DavidGilmour1984/Colorimeter/SCH_LDR Colorometer Spectrometer motherboard 3_2025-11-26.pdf

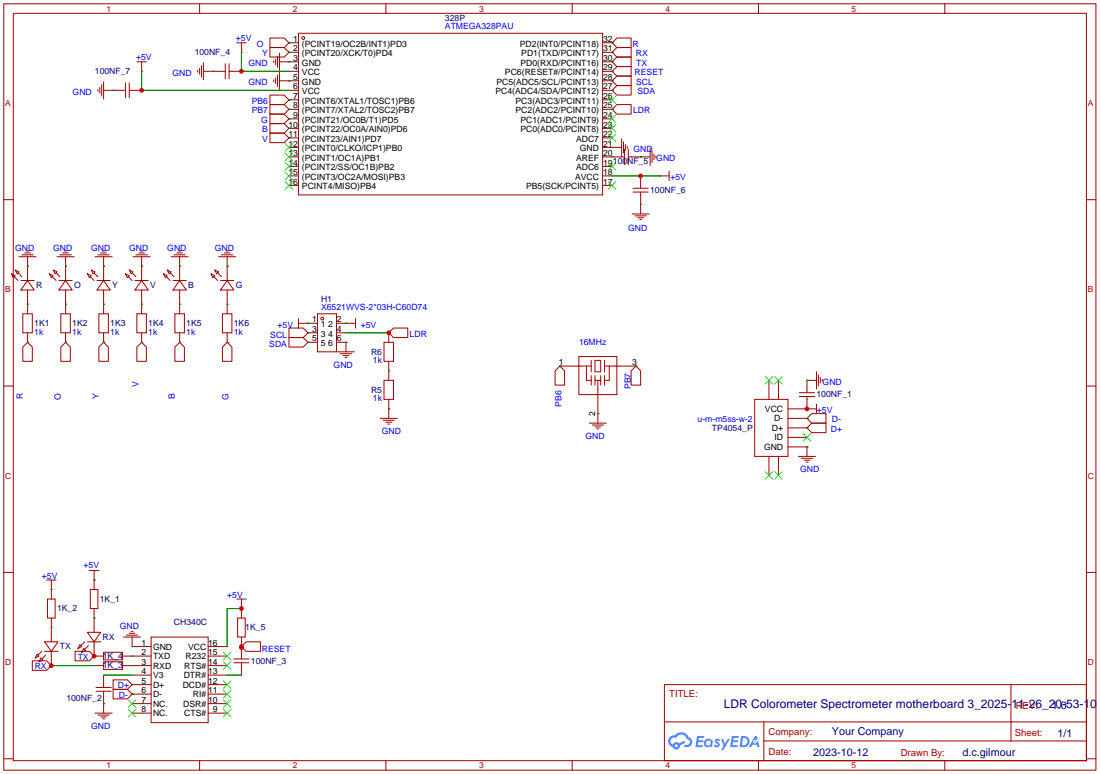
[picture p1: page 1]

LDR Colorometer Spectrometer motherboard 3_2025-11-26_20-53-10 1.0
