DavidGilmour1984/Colorimeter/(commit log)

2026-08-09 Convert Colorimeter to web-based interface
    Replaced Arduino code with HTML and JavaScript for a web-based absorbance colorimeter interface.
    [Colorimeter.ino]
2026-08-09 Revise calibration procedure in README
    Updated calibration instructions to emphasize covering the cuvette and keeping the device flat during the process.
2026-08-09 Enhance calibration steps in colorimeter instructions
    Updated calibration instructions for clarity and added a step to block light during calibration.
